ccbtokyo/visvib-manual/docs/README.md

# CCBT VisVib



## 概要

このプロジェクトは、[シビック・クリエイティブ・ベース東京（CCBT）](https://ccbt.rekibun.or.jp/)、[東京藝術大学芸術情報センター（AMC）](https://amc.geidai.ac.jp/)、および[東京文化会館](https://www.t-bunka.jp/)が共同で行ったものです。ろう者・難聴者も含めて音楽を楽しめるような音楽ワークショップの開発過程で生まれた、トーンチャイムという楽器を用いて、その音を光や映像としても体験できるシステム **「VisVib」** を開発しました。

本プロジェクトで開発した成果をより広く共有するべく、**VisVib** のシステムをオープンソース化しています。

デバイスやワークショップの開発過程は、CCBTウェブサイト「[リサーチノート](https://ccbt.rekibun.or.jp/research-notes/diverstiy-and-inclusion-project-02)」で公開されています。

<div class="video-container">
<div class="video-wrapper">
<iframe width="2014" height="1075" src="https://www.youtube.com/embed/hWaFJXojxO8" title="VisVibの使い方｜セットアップ編" frameborder="0" allow="accelerometer; autoplay; clipboard-write; encrypted-media; gyroscope; picture-in-picture; web-share" referrerpolicy="strict-origin-when-cross-origin" allowfullscreen></iframe>
</div>

<div class="video-wrapper">
<iframe width="2014" height="1075" src="https://www.youtube.com/embed/KC6nucvaL8E" title="VisVibの使い方｜実践編" frameborder="0" allow="accelerometer; autoplay; clipboard-write; encrypted-media; gyroscope; picture-in-picture; web-share" referrerpolicy="strict-origin-when-cross-origin" allowfullscreen></iframe>
</div>
</div>

## 目次

1. [準備：ハードウェア編](Preparation/Hardware/index.md)
2. [準備：ソフトウェア編](Preparation/Software/index.md)
3. [セットアップ編](Setup/index.md)
4. [立ち上げ-運用編](Usage/index.md)
5. [トラブルシューティング](Troubleshooting/index.md)

## [ライセンス](https://github.com/ccbtokyo/visvib-manual/blob/main/LICENSE)

本プロジェクトに関わるプログラムのソースコードは、MITライセンスで公開されています。また、プログラム以外のドキュメント、3Dモデルデータはクリエイティブ・コモンズ4.0-表示（CC4.0-BY）で公開されています。

## クレジット

- 音センサーシステム開発：[松浦知也(@tomoyanonymous)](https://matsuuratomoya.com)
- 映像システム開発：薄羽涼彌

デバイス開発：

- [伊藤隆之](https://ccbt.rekibun.or.jp/players/ito-takayuki)（シビック・クリエイティブ・ベース東京［CCBT］テクニカルディレクター）
- [イトウユウヤ](https://ccbt.rekibun.or.jp/players/ito-takayuki)
  （テクニカルディレクター／[arsaffix](https://arsaffix.com/)）
- 三浦大輝（エンジニア）
- 多田伊吹（CCBTインターン（2022-23年）／ろう者）

ワークショップ開発：

- 伊原小百合（東京文化会館ワークショップ・リーダー）
- 坂本夏樹（東京文化会館ワークショップ・リーダー）
- 櫻井音斗（東京文化会館ワークショップ・リーダー）
- 古橋果林（東京文化会館ワークショップ・リーダー）
- Sasa／Marie（SignPoet（手話による「てことば」で詩を紡ぐ人）、ミュージック・アクセシビリティ・リサーチャー／ろう者）

コミュニケーション支援（日本手話言語⇔日本語）：

- 石川ありす
- 篠塚正行
- 小貫美奈（筑波技術大学）

## ドキュメントの管理・開発

[DEVELOPMENT](Development/index.md) を参照してください。

## 関連リンク

- [シビック・クリエイティブ・ベース東京［CCBT］](https://ccbt.rekibun.or.jp/)
- [CCBT GitHub](https://github.com/ccbtokyo)
