ccbtokyo/visvib-manual/docs/img/attach-position.jpg

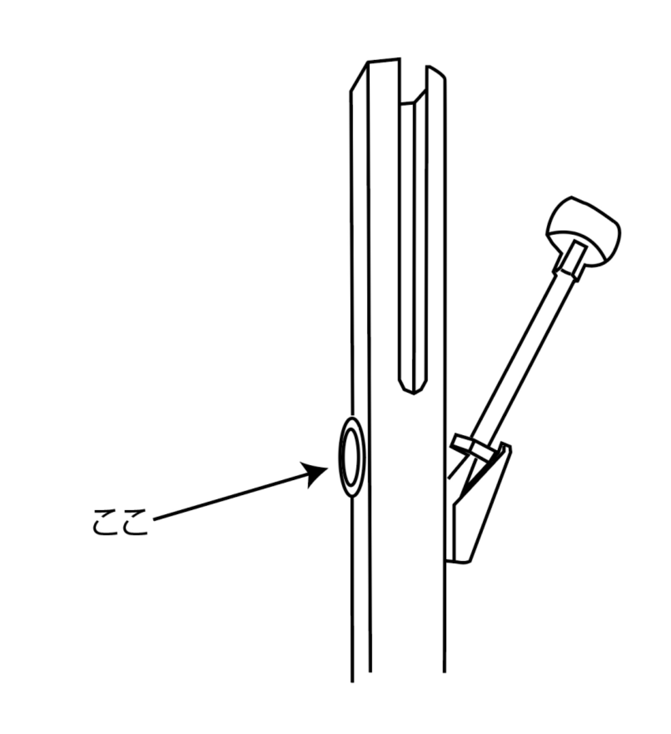
docs/img/attach-position.jpg
