ccbtokyo/visvib-manual/docs/img/hittsukimushi.JPG

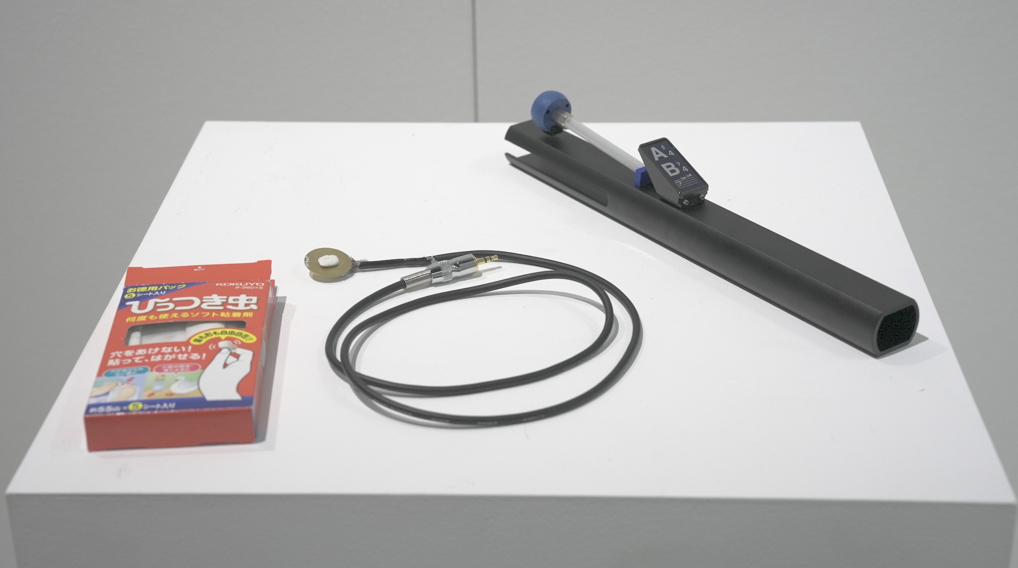
docs/img/hittsukimushi.JPG
