ccbtokyo/visvib-manual/docs/img/max_config.png

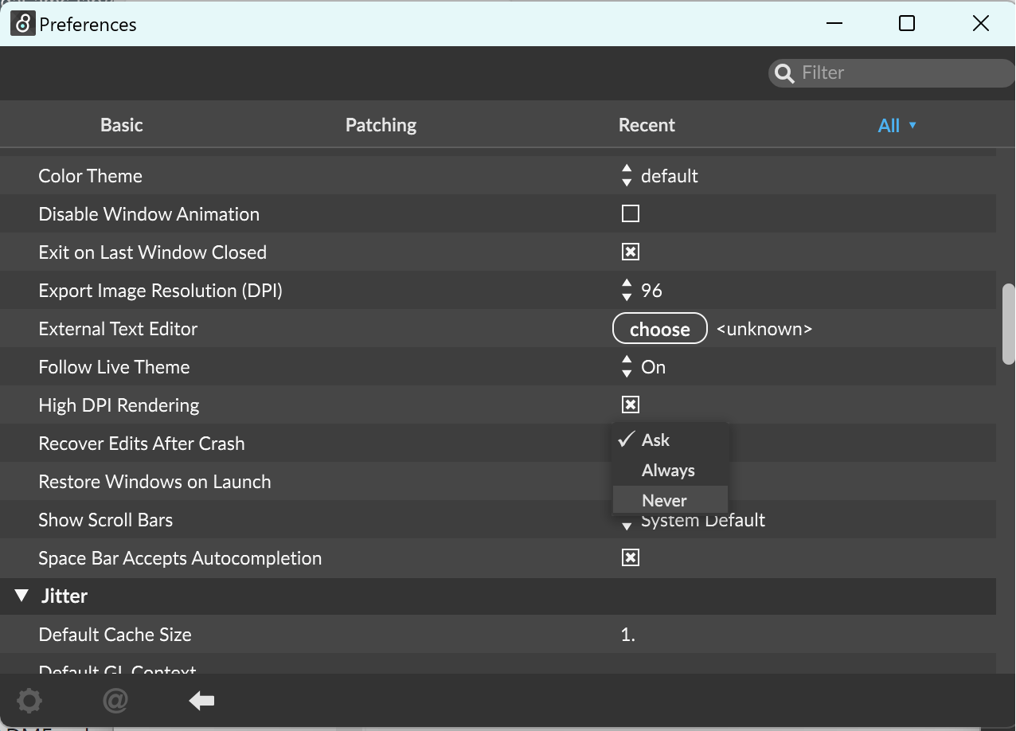
docs/img/max_config.png
