ccbtokyo/visvib-manual/docs/3dmodels/shadow-cover_small.stl

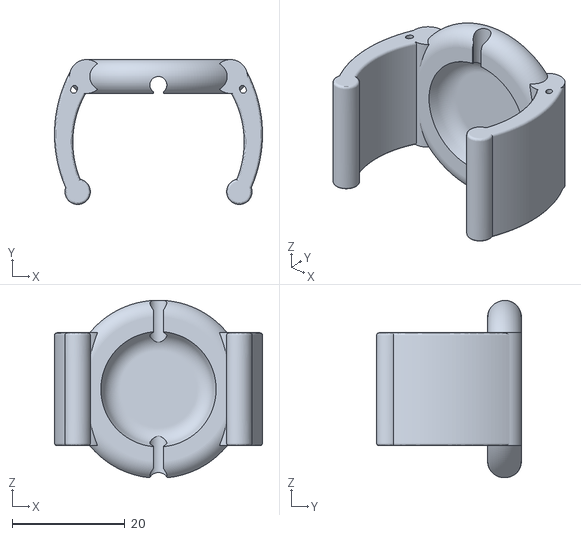
[picture p12: CAD file, 2025-12-26]
docs/3dmodels/shadow-cover_small.stl
36.8 x 25.7 x 31.4
