ccbtokyo/visvib-manual/docs/3dmodels/shadow-cover_large.stl

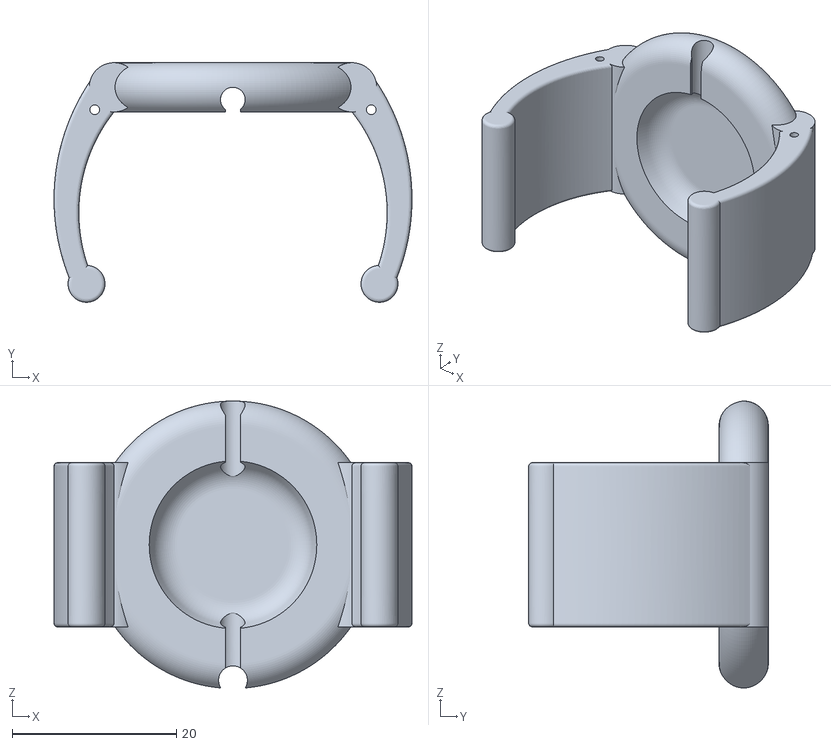
[picture p13: CAD file, 2025-12-26]
docs/3dmodels/shadow-cover_large.stl
43.6 x 29.2 x 34.9
