ccbtokyo/visvib-manual/docs/3dmodels/shadow-clip_small.stl

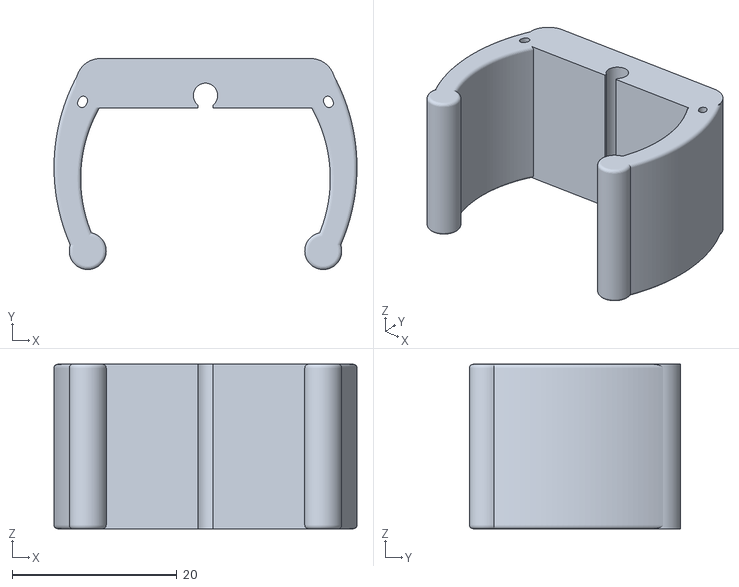
[picture p14: CAD file, 2025-12-26]
docs/3dmodels/shadow-clip_small.stl
36.8 x 25.7 x 20.0
