ccbtokyo/visvib-manual/docs/3dmodels/shadow-clip_large.stl

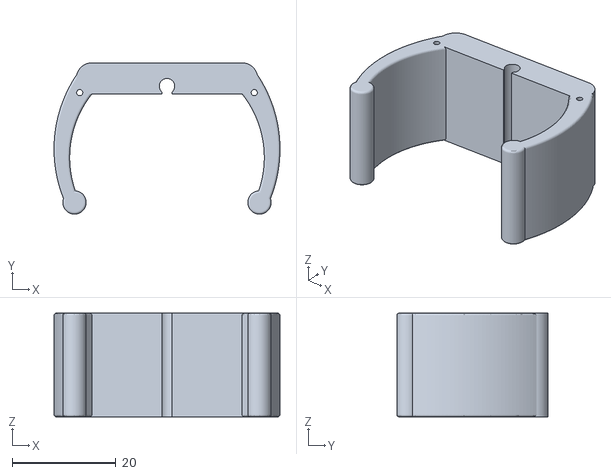
[picture p15: CAD file, 2025-12-26]
docs/3dmodels/shadow-clip_large.stl
43.6 x 29.2 x 20.0
