ccbtokyo/visvib-manual/docs/3dmodels/piezo_cover_small.stl

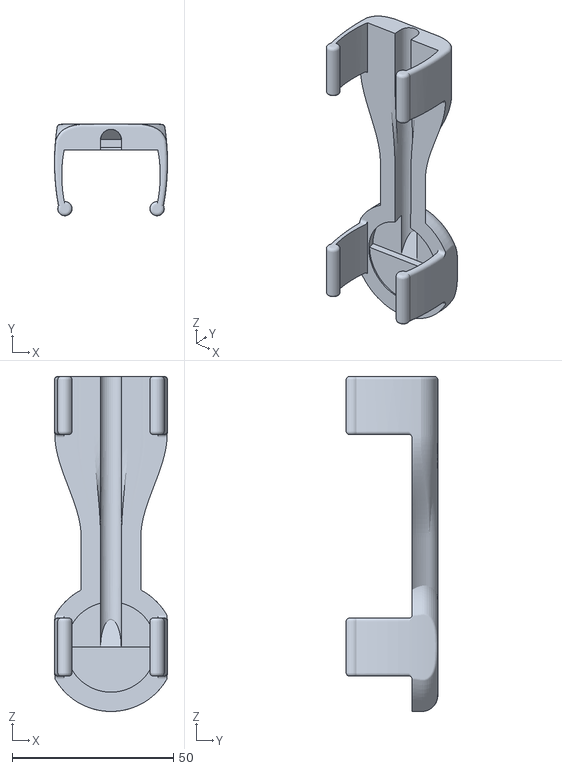
[picture p16: CAD file, 2024-06-19]
docs/3dmodels/piezo_cover_small.stl
35.1 x 28.5 x 104.0
