ccbtokyo/visvib-manual/docs/3dmodels/cableclip_large.stl

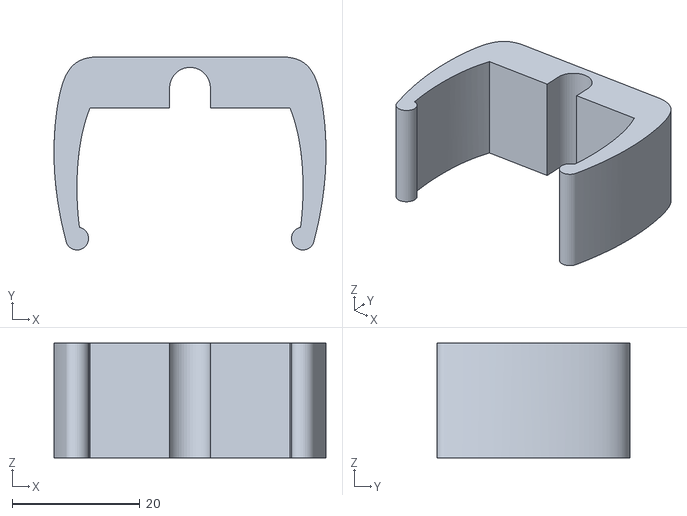
[picture p17: CAD file, 2024-06-19]
docs/3dmodels/cableclip_large.stl
42.6 x 30.2 x 18.0
