ccbtokyo/visvib-manual/docs/3dmodels/cableclip_small.stl

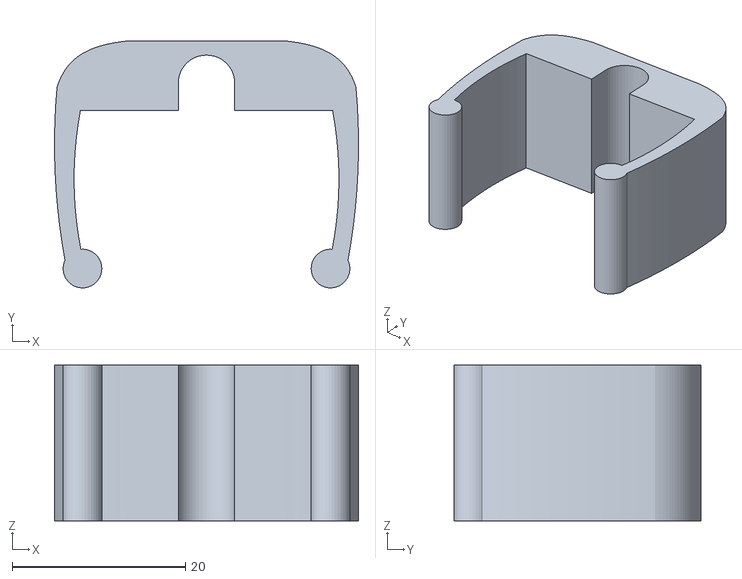
[picture p18: CAD file, 2024-06-19]
docs/3dmodels/cableclip_small.stl
35.1 x 28.5 x 18.0
