ccbtokyo/visvib-manual/docs/3dmodels/piezo_cover_large.stl

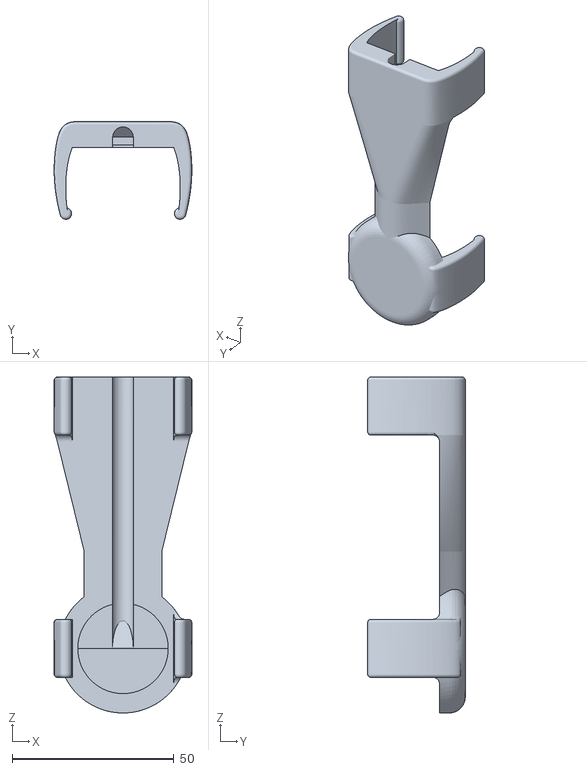
[picture p19: CAD file, 2024-06-19]
docs/3dmodels/piezo_cover_large.stl
42.6 x 30.2 x 104.0
