ccbtokyo/visvib-manual/(threads)

Thread 2 (2024-06-16):

英語用ページ追加

Eotel, 2024-06-16:

tomoyanonymous, 2024-07-21:
https://github.com/ccbtokyo/visvib-manual/commit/84d65c8c28ccf43b156f0cee9fb7c7cd024a8e55

軽く翻訳しました、チェック待ち。

Mkdocs-MaterialにLanguage-Selectorの設定があって、正しくtomlも設定されてるはずなのだが、メニューに切り替えボタンが出てこない？

https://squidfunk.github.io/mkdocs-material/setup/changing-the-language/

Thread 8 (2024-07-25):

日本語タイトルへのアンカー

Eotel, 2024-07-25:
`[page](index.md#head1)` のようにアンカリングしたいとき，日本語で始まる見出しだと `#_n` (nは自然数) のようなアンカーが生成される．

このままだと参照しにくいので，`attr_list` を使って任意の id を見出しに付加する

Eotel, 2024-07-25:
真似できる？

```
- toc:
    permalink: "#"          # heading anchor
    slugify: !!python/name:pymdownx.slugs.uslugify     # 解决中文标题解析问题
```

Eotel, 2024-07-25:
> デフォルト=markdown.extensions.headerid.slugify（項目名にASCII以外の文字列は番号と記号に置き換えられる）、function(value, separator):の引数を持つ関数を定義して渡すことによって、アンカーリンクの名前を変更することできる。

https://zerofromlight.com/blogs/detail/111/

ということらしい

Eotel, 2024-07-25:
関数の参照について

https://facelessuser.github.io/pymdown-extensions/faq/
