ccbtokyo/visvib-manual/(commit log)

2024-06-04 added 3d model data
    [cableclip_large.stl, cableclip_small.stl, piezo_cover_large.stl, piezo_cover_small.stl]
2024-06-15 🙈 add a .gitignore
2024-06-16 ✏️ URL 修正
2024-06-16 🚚 README.md を docs/ 以下で管理する
    * 相対パス指定も修正
2024-06-16 🎨 フォーマット
2024-06-16 🎨 CCBT Players ページのリンク追加
2024-06-16 🚧 英語用README.md追加
    TODO #1 英語用ページ作成
2024-06-16 ✨ MkDocs によるドキュメントのビルド機能を追加
    main ブランチに新しいpushがあった時にリビルドして，GitHub Pagesにホスティングする
2024-06-16 ✨ GitHub Workflow 追加
2024-06-16 📝 未作成のページを追加(空)
2024-06-16 🙈 ビルド済みのドキュメントをignore
2024-06-17 📝 Add development section to README
2024-06-19 poetryのinstallはsetup-pythonより前にやる必要あり
2024-06-19 Update README.md
    READMEにドキュメントデプロイのステータスバッジを追加
2024-06-19 デプロイ時にforce-pushするように変更
2024-07-21 english translation
    [cableclip_large.stl, cableclip_small.stl, piezo_cover_large.stl, piezo_cover_small.stl]
2024-07-22 ➕ mkdocs-static-i18n 追加
2024-07-22 🎨 ディレクトリ構造をページトピックごとに分ける
2024-07-22 🩹 Homeで言語切り替えがうまくいかない問題を修正
2024-07-23 URLをクリック可能に変更
2024-07-25 🎨 フォーマッターによる自動改行を削除
2024-07-25 🎨 表記修正
2024-08-25 💄 Refine documentation text and formatting
    Updated multiple documentation files to improve readability and consistency. Adjustments include text formatting, clarifying button and label names, and reorganizing some sentences for better clarity.
2024-08-31 Update README.md
    動画が出来上がったので差し込み
2024-08-31 Add video embeds and styling to README
    Inserted YouTube video tutorials into the README to provide visual guidance on using VisVib. Added new CSS file to style the video embeds for responsive display. Adjusted text formatting and made minor edits for clarity.
2024-09-01 マージ時に誤って取り込んだDiffを削除
2024-09-05 冗長な記述を削除
2024-09-05 ハードウェア編の表現を修正
2024-09-05 ソフトウェア編を更新
2024-09-05 照明のトラブルシューティングを追記
2024-09-05 実践編の画像をたくさん追加
2024-09-05 コンタクトマイク制作の写真追加
2024-09-05 英語版を更新
2024-10-10 Readmeを修正しました
2024-10-11 Readmeへの画像の追加
2024-10-17 docs: Update documentation with logo image and related links.
    - Updated `.gitignore` to ignore `.idea/` directory.
    - Added a logo image for the material theme
    - Added `ccbt_logo.png` in the `docs/img/` directory.
    - Updated the README.md file in the docs folder
    - Added related links to the end of the README.md file
2024-11-09 全体システム構成図の画像を追加
2024-11-09 英語版にシステム構成図画像追加
2024-11-09 フォーマット修正
2024-11-09 英語版Readmeの修正
2025-12-26 added explanation for shadow microphone
    [shadow-clip_large.stl, shadow-clip_small.stl, shadow-cover_large.stl, shadow-cover_small.stl]
